swordey/smarthomeproject/imgs/temp_sensor.JPG

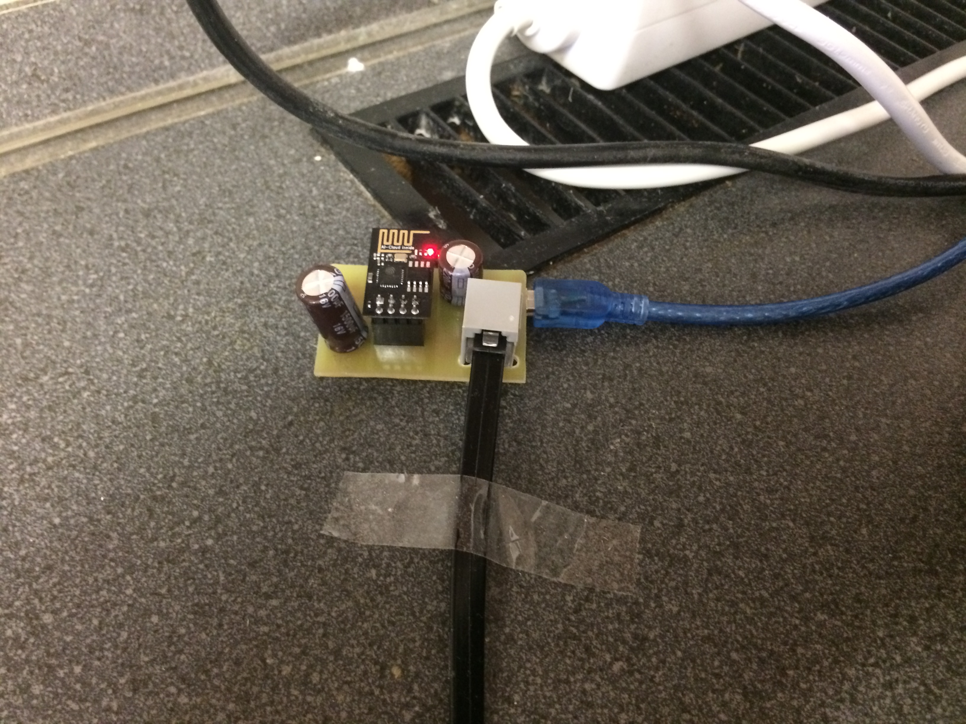
imgs/temp_sensor.JPG
