swordey/smarthomeproject/imgs/hw_arch/esp8266_ds18b20_thermometer.jpg

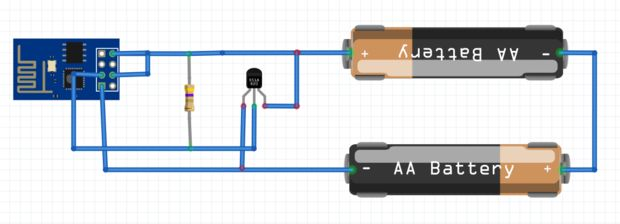
imgs/hw_arch/esp8266_ds18b20_thermometer.jpg
