swordey/smarthomeproject/code/android/pictures/add.png

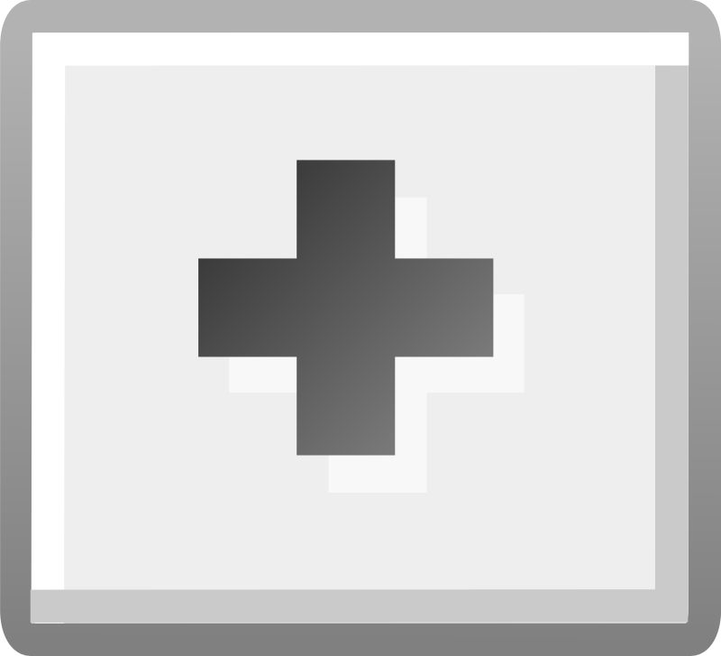
code/android/pictures/add.png
