swordey/smarthomeproject/code/android/pictures/edit.jpg

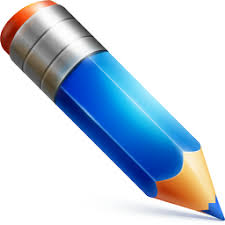
code/android/pictures/edit.jpg
