swordey/smarthomeproject/code/android/pictures/settings.png

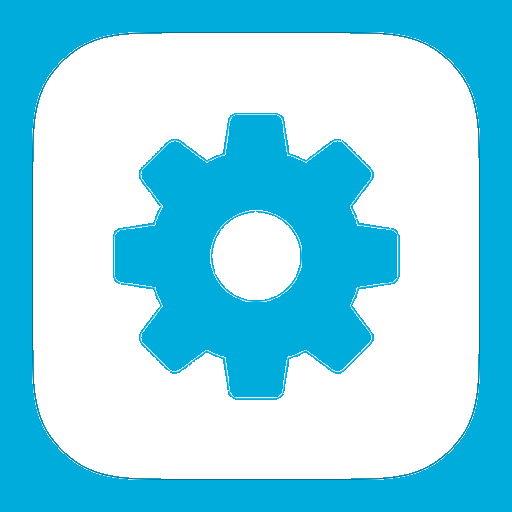
code/android/pictures/settings.png
