swordey/smarthomeproject/code/android/pictures/settings_orig.png

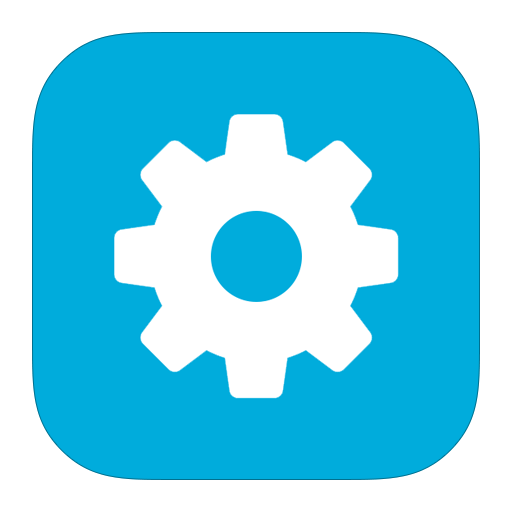
code/android/pictures/settings_orig.png
