swordey/smarthomeproject/imgs/units/relay_unit_bottom.jpg

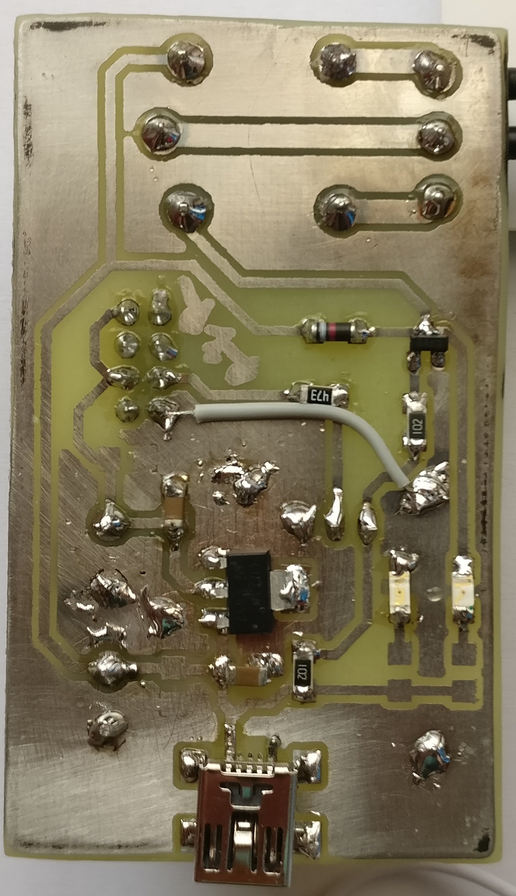
imgs/units/relay_unit_bottom.jpg
