swordey/smarthomeproject/imgs/units/sensor_unit_bottom.jpg

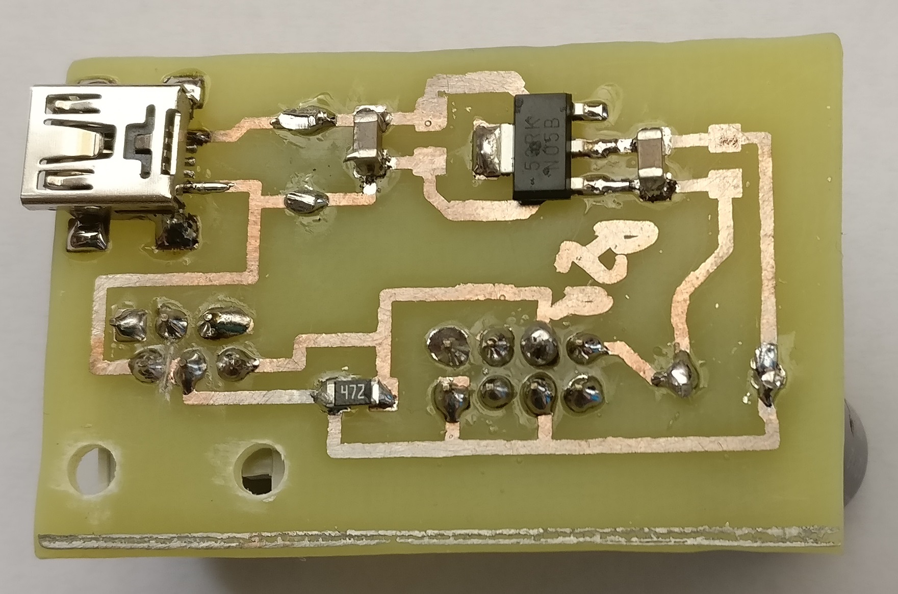
imgs/units/sensor_unit_bottom.jpg
