swordey/smarthomeproject/imgs/units/sensor_unit_up.jpg

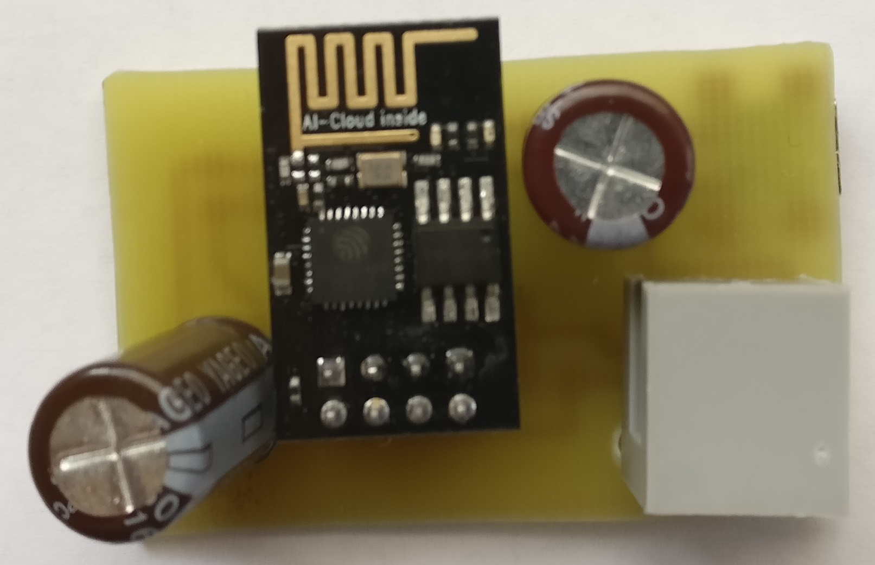
imgs/units/sensor_unit_up.jpg
