swordey/smarthomeproject/pcb/imgs/thermo_pcb.PNG

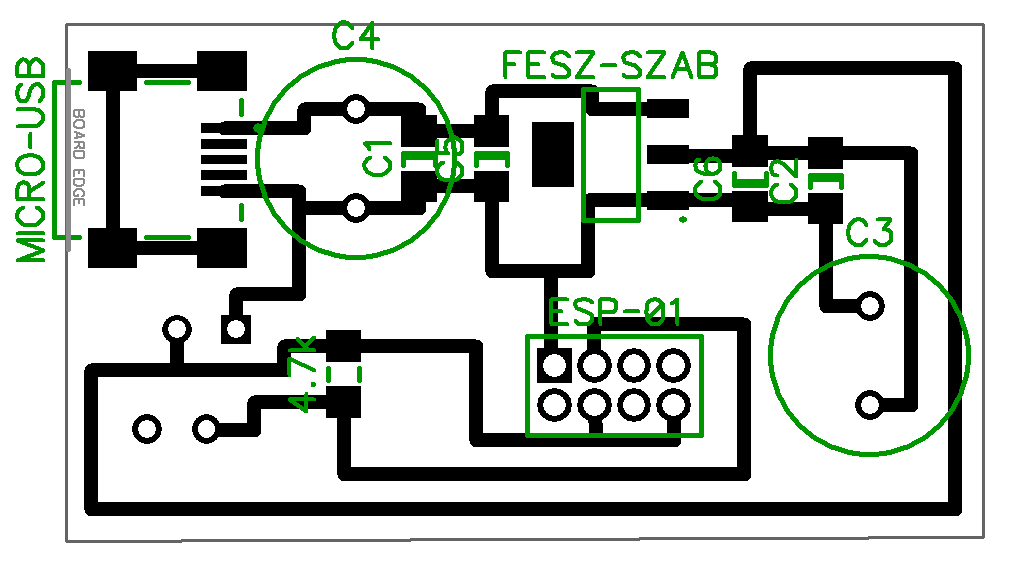
pcb/imgs/thermo_pcb.PNG
