swordey/smarthomeproject/pcb/print/relay_pcb_esp.pdf

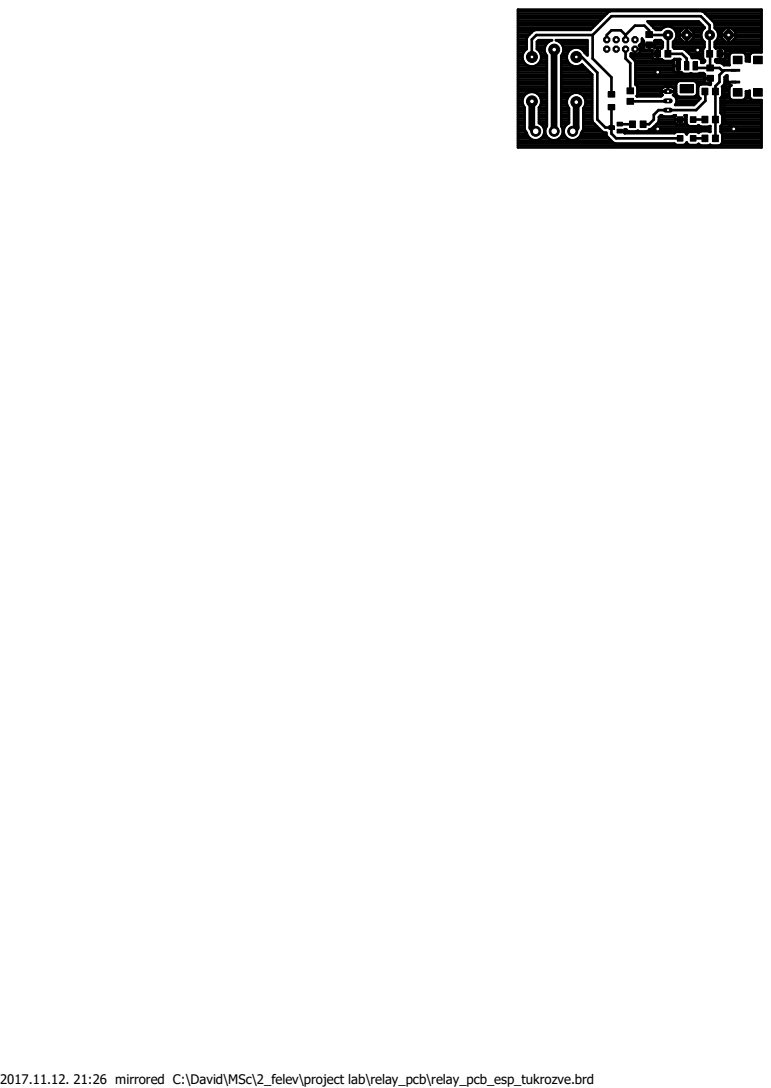
[picture p37: page 1]

2017.11.12. 21:26 mirrored C:\David\MSc\2_felev\project lab\relay_pcb\relay_pcb_esp_tukrozve.brd
