swordey/smarthomeproject/pcb/print/thermo_rj11_pcb.pdf

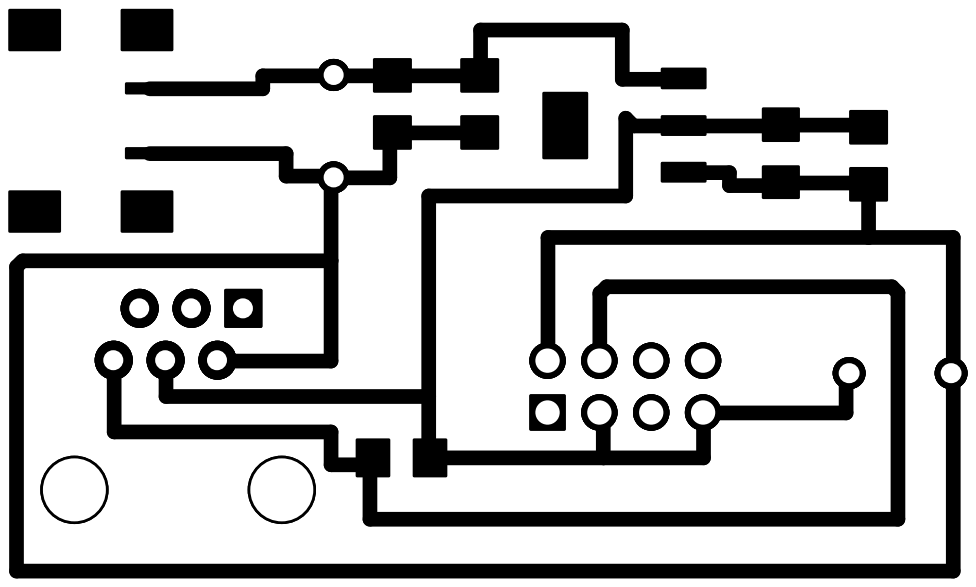
[picture p38: page 1]
