swordey/smarthomeproject/(list of files, drawings)

Other design files:
pcb/done_pcb_thermo.dip
pcb/power_supply.dch
pcb/temp_connection.dch
pcb/temp_sensor.dch
pcb/thermo_pcb.dip
pcb/thermo_rj11.dip
pcb/thermo_rj11_jo.dip
